joyfab/rp2040suntracker/Suntracker_v1_2.sch

## EAGLE design Suntracker_v1_2.sch (2025-01-23)

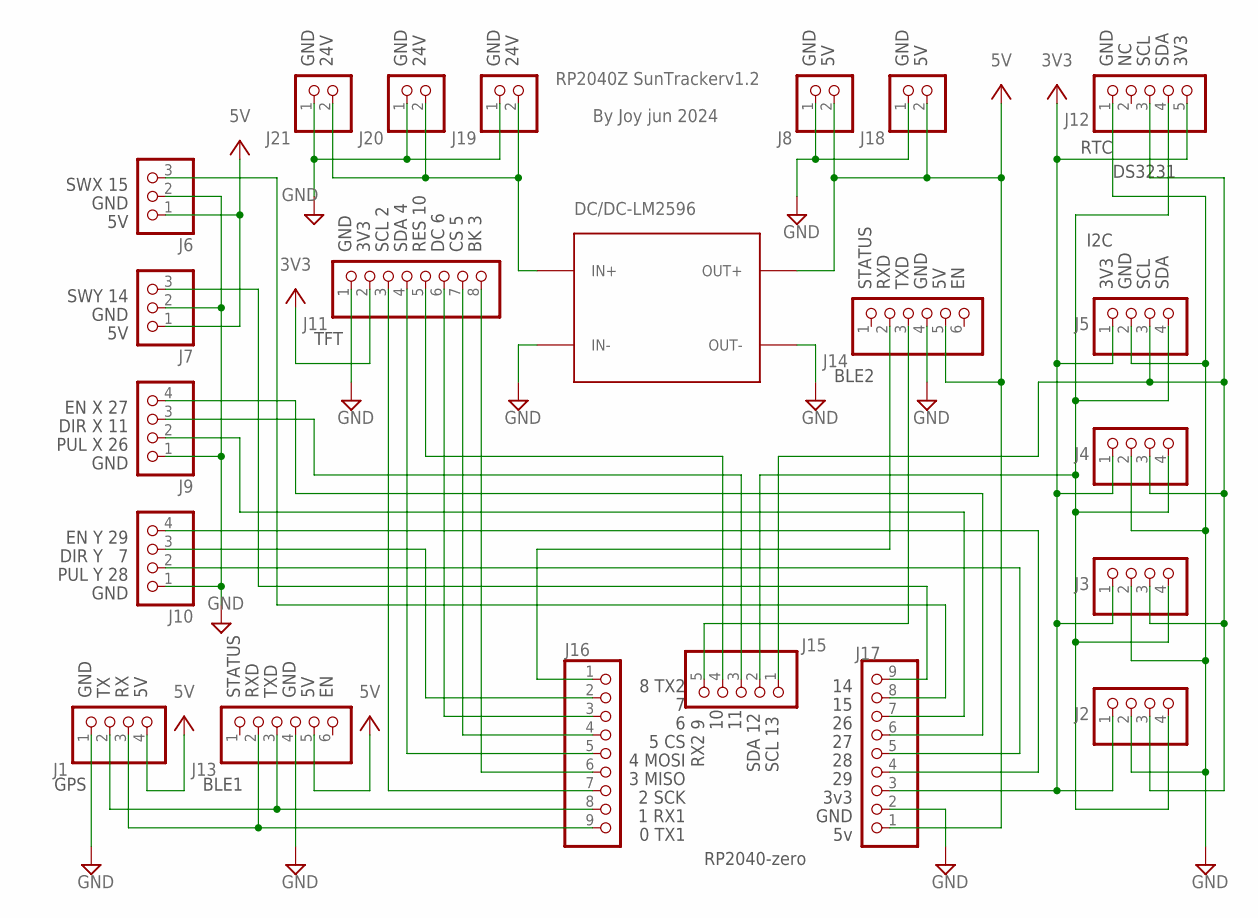
[picture p1: schematic Suntracker_v1_2.sch]

Parts:
J1, J2, J3, J4, J5, J9, J10: PINHD-1X04_2.54; 1X04
J6, J7: PINHD-1X3; 1X03
J8, J18, J19, J20, J21: PINHD-1X2; 1X02
J11: PINHD-1X8; 1X08
J12, J15: PINHD-1X05_2.54; 1X05
J13, J14: PINHD-1X06_2.54; 1X06
J16, J17: PINHD-1X9/90; 1X09/90
U1: DC/DC-LM2596; DC-DC-STEP-DOWN-LM2596

Connections:
GND: J1.1, J2.2, J3.2, J4.2, J5.2, J6.2, J7.2, J8.1, J9.1, J10.1, J11.1, J12.1, J13.4, J14.4, J17.2, J18.1, J19.1, J20.1, J21.1, U1.IN-, U1.OUT-
unnamed: J14.2, J16.1
unnamed: J11.5, J15.4
unnamed: J1.3, J13.2, J16.9
unnamed: J2.3, J3.3, J4.3, J5.3, J12.3, J15.1
unnamed: J1.2, J13.3, J16.8
unnamed: J14.3, J15.5
unnamed: J11.3, J16.7
unnamed: J11.8, J16.6
unnamed: J11.4, J16.5
unnamed: J11.7, J16.4
unnamed: J19.2, J20.2, J21.2, U1.IN+
unnamed: J2.4, J3.4, J4.4, J5.4, J12.4, J15.2
unnamed: J11.6, J16.3
unnamed: J9.2, J17.7
unnamed: J10.4, J17.4
unnamed: J10.2, J17.5
unnamed: J10.3, J16.2
unnamed: J9.3, J15.3
unnamed: J9.4, J17.6
unnamed: J7.3, J17.9
unnamed: J6.3, J17.8
V+: J1.4, J2.1, J3.1, J4.1, J5.1, J6.1, J7.1, J8.2, J11.2, J12.5, J13.5, J14.5, J17.1, J17.3, J18.2, U1.OUT+

Notes on the sheet:
GPS
DS3231
STATUS
TXD
RXD
GND
0 TX1
BLE1
1 RX1
2 SCK
3 MISO
4 MOSI
5 CS
8 TX2
3v3
BLE2
RX2 9
SDA 12
SCL 13
TFT
RP2040-zero
I2C
SWY 14
SWX 15
DIR X 11
PUL X 26
DIR Y 7
EN X 27
PUL Y 28
EN Y 29
24V
3V3
SCL 2
SDA 4
RES 10
DC 6
CS 5
BK 3
SCL
RTC
SDA
RP2040Z SunTrackerv1.2
By Joy jun 2024
